kavishanGT/Electronic_Stethoscope/README.md

# Electronic_Stethoscope
E-Stethoscope is a real-time electronic stethoscope system designed to acquire, process, visualize, and record heart sounds (phonocardiogram – PCG) using an ESP32-based acquisition unit, MATLAB signal-processing
