kavishanGT/Electronic_Stethoscope/design files/New folder/Estetoscopio.SLDASM

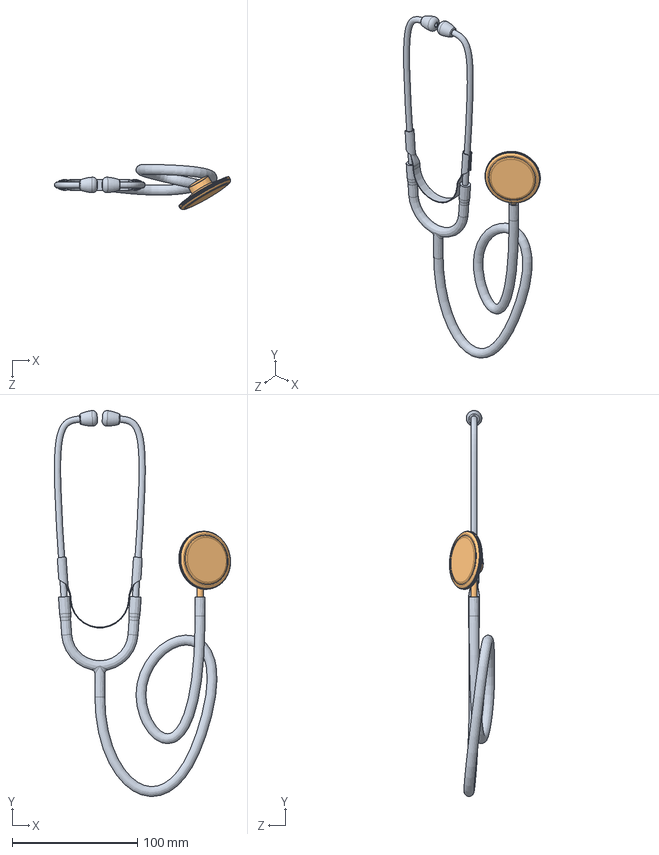
[picture p31: CAD file, 2025-12-25]
design files/New folder/Estetoscopio.SLDASM
140.6 x 307.9 x 36.1 mm
Olivas^_Estetoscopio
membrana^_Estetoscopio
