kavishanGT/Electronic_Stethoscope/design files/New folder/Assem1.SLDASM

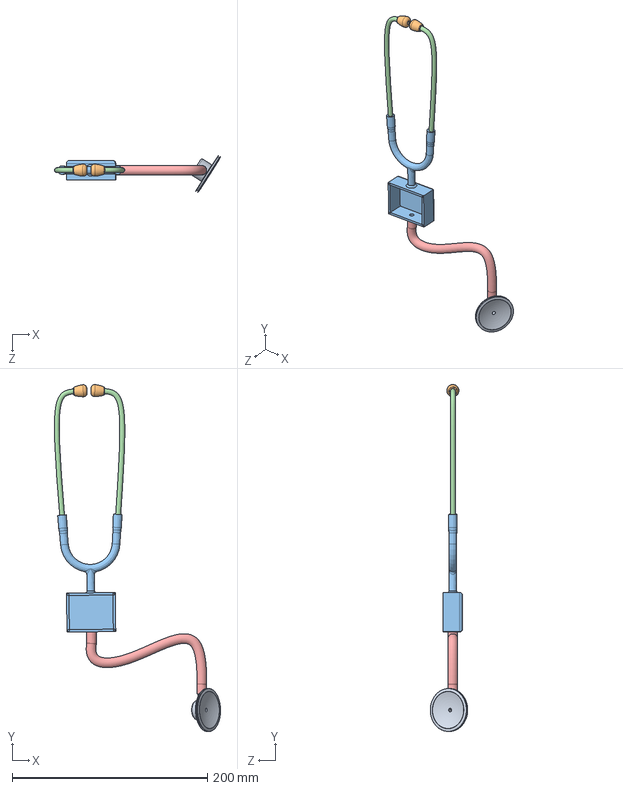
[picture p32: CAD file, 2025-12-25]
design files/New folder/Assem1.SLDASM
170.2 x 355.4 x 38.4 mm
chestPiece2-V2
earknobs-seth
yshape-steth-withBOX
2bars-steth
tube
