kavishanGT/Electronic_Stethoscope/design files/chestPiece2-V4.SLDPRT

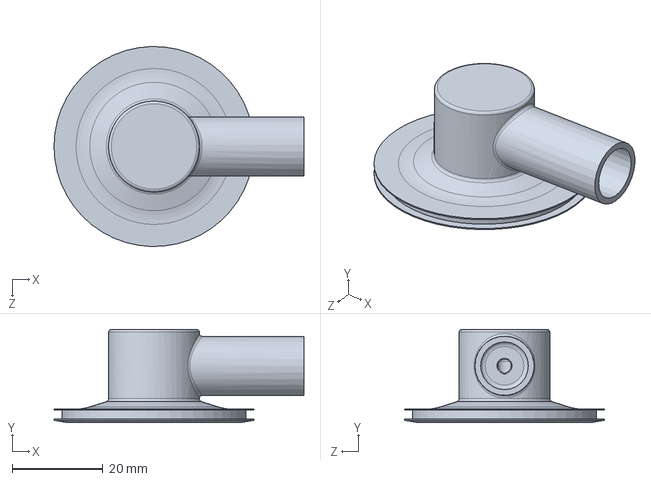
[picture p33: CAD file, 2025-12-25]
design files/chestPiece2-V4.SLDPRT
55.0 x 20.5 x 44.0 mm
