kavishanGT/Electronic_Stethoscope/design files/blabla.SLDPRT

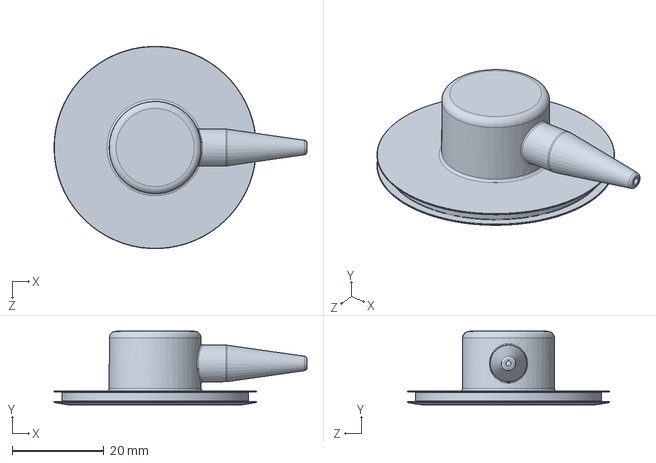
[picture p34: CAD file, 2025-12-25]
design files/blabla.SLDPRT
55.0 x 16.0 x 44.0 mm
