kavishanGT/Electronic_Stethoscope/design files/boxPartV3.SLDPRT

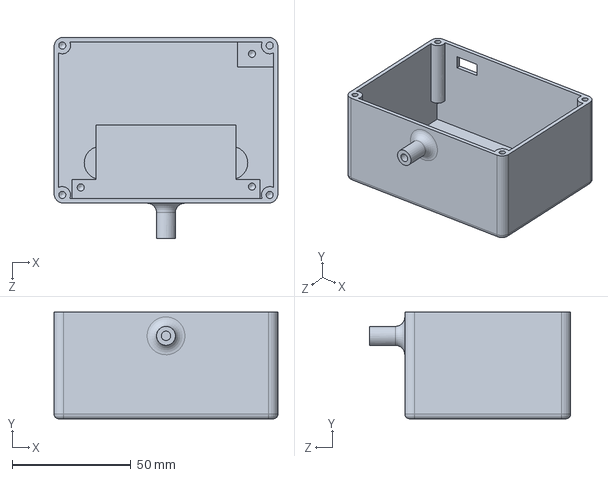
[picture p35: CAD file, 2025-12-25]
design files/boxPartV3.SLDPRT
94.5 x 45.0 x 85.0 mm
