kavishanGT/Electronic_Stethoscope/design files/New folder/steth - 2.SLDPRT

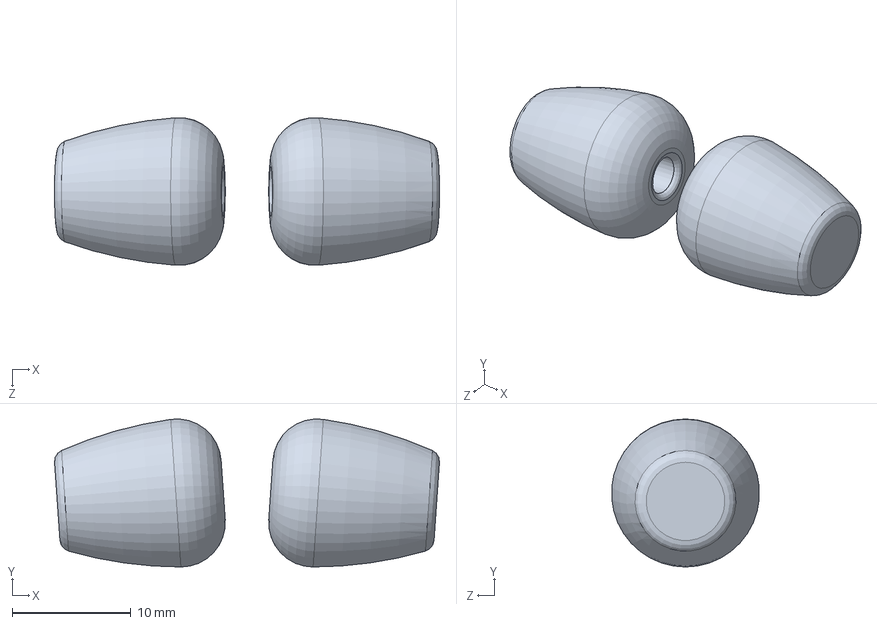
[picture p36: CAD file, 2025-12-25]
design files/New folder/steth - 2.SLDPRT
32.4 x 12.4 x 12.4 mm
