kavishanGT/Electronic_Stethoscope/design files/chestPiece2.SLDPRT

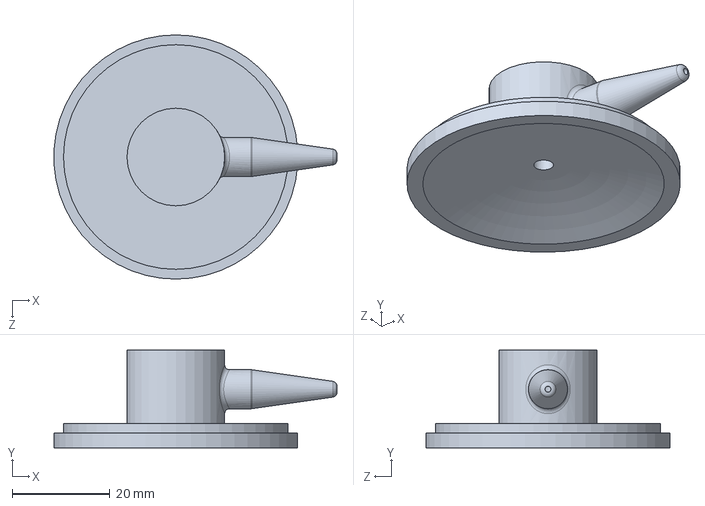
[picture p37: CAD file, 2025-12-25]
design files/chestPiece2.SLDPRT
58.0 x 20.0 x 50.0 mm
