kavishanGT/Electronic_Stethoscope/design files/New folder/yshape-steth.SLDPRT

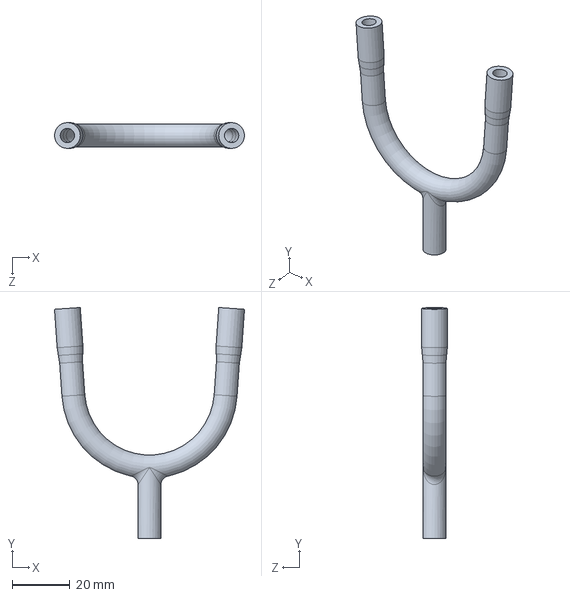
[picture p38: CAD file, 2025-12-25]
design files/New folder/yshape-steth.SLDPRT
66.1 x 80.3 x 9.00 mm
