kavishanGT/Electronic_Stethoscope/design files/New folder/yshape-steth-V2-withbox.SLDPRT

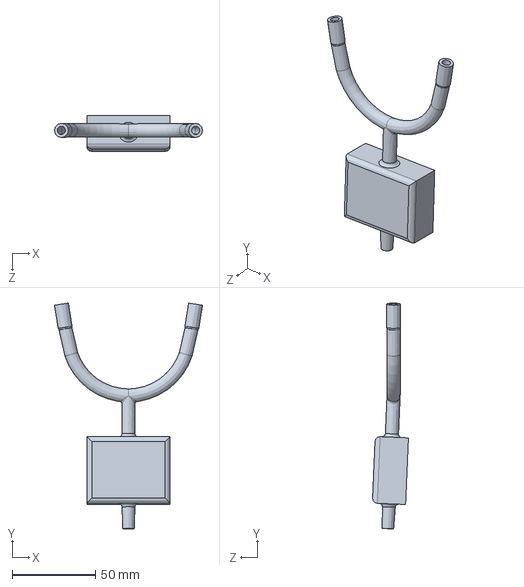
[picture p39: CAD file, 2025-12-25]
design files/New folder/yshape-steth-V2-withbox.SLDPRT
88.9 x 135.6 x 21.6 mm
