kavishanGT/Electronic_Stethoscope/design files/ring.SLDPRT

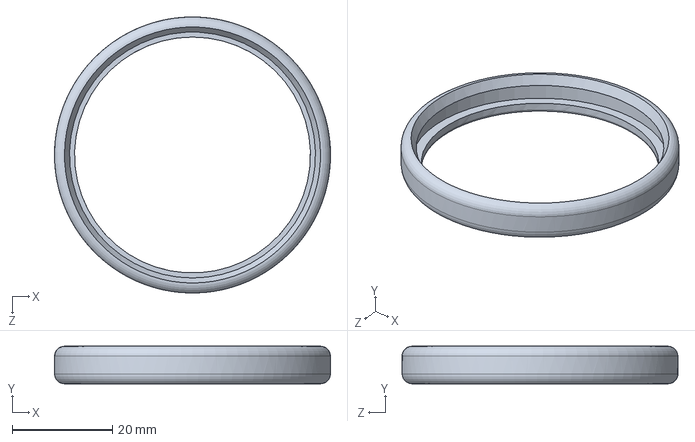
[picture p40: CAD file, 2025-12-25]
design files/ring.SLDPRT
55.0 x 7.50 x 55.0 mm
