kavishanGT/Electronic_Stethoscope/design files/boxLid.SLDPRT

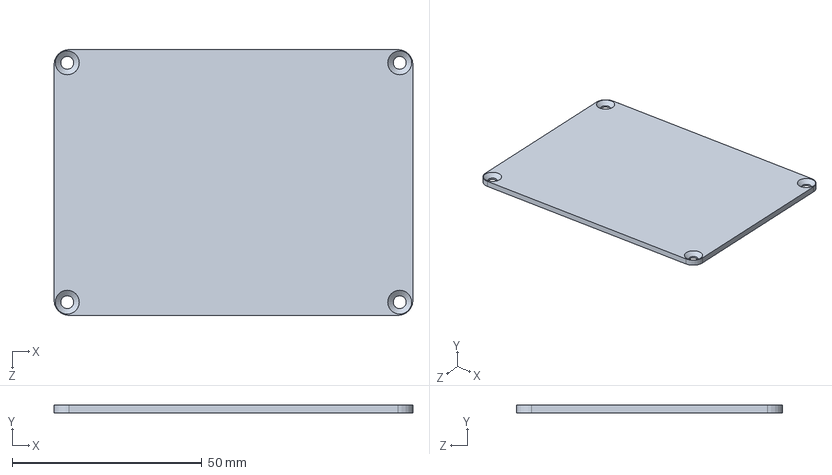
[picture p41: CAD file, 2025-12-25]
design files/boxLid.SLDPRT
94.5 x 2.00 x 70.0 mm
