kavishanGT/Electronic_Stethoscope/design files/New folder/2bars-steth.SLDPRT

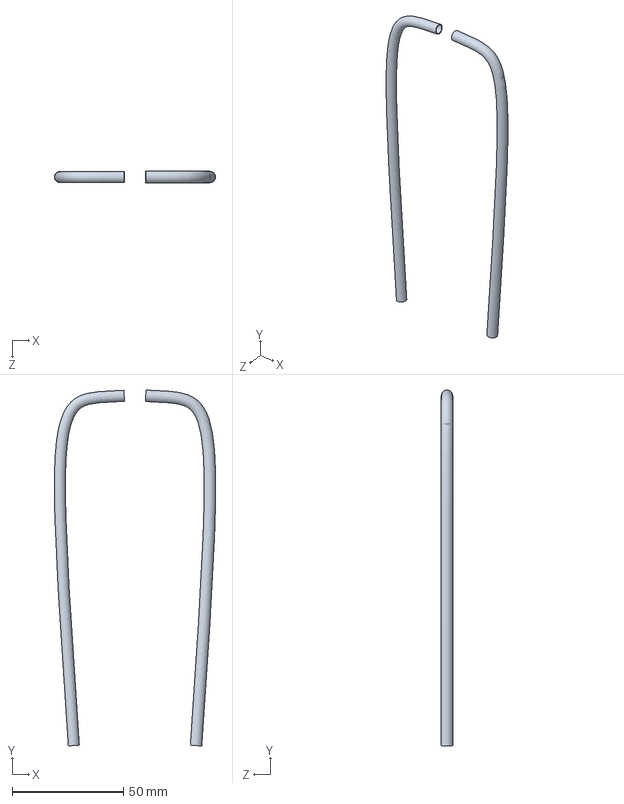
[picture p42: CAD file, 2025-12-25]
design files/New folder/2bars-steth.SLDPRT
72.6 x 160.2 x 5.20 mm
