kavishanGT/Electronic_Stethoscope/design files/chestPiece.SLDPRT

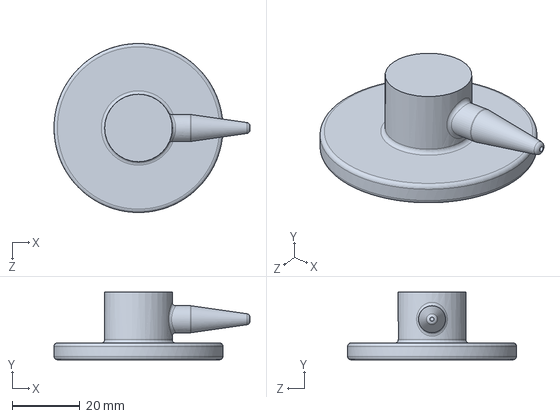
[picture p43: CAD file, 2025-12-25]
design files/chestPiece.SLDPRT
58.0 x 20.0 x 50.0 mm
