kavishanGT/Electronic_Stethoscope/design files/New folder/steth.SLDPRT

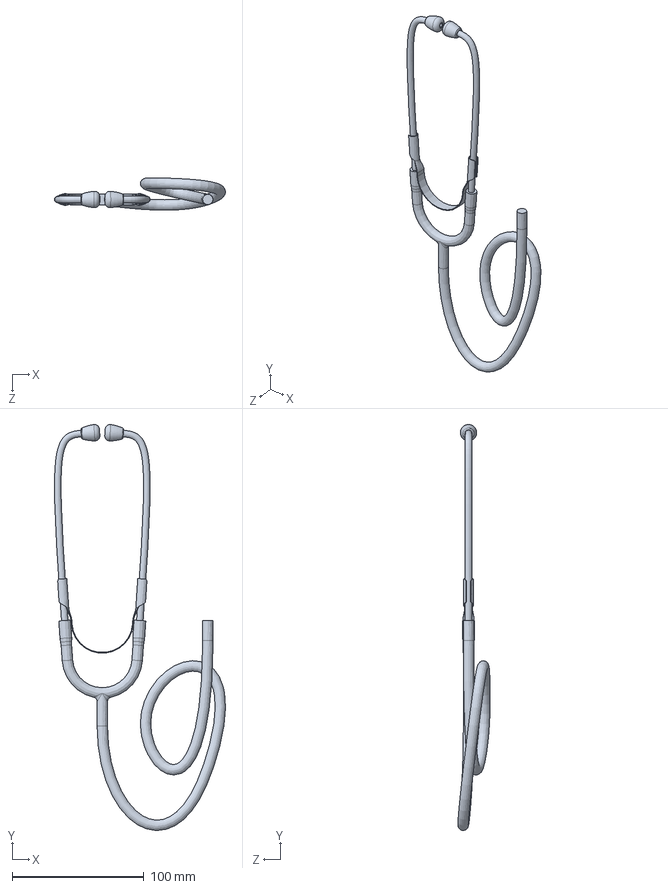
[picture p44: CAD file, 2025-12-25]
design files/New folder/steth.SLDPRT
129.7 x 307.9 x 24.5 mm
