kavishanGT/Electronic_Stethoscope/design files/boxPart.SLDPRT

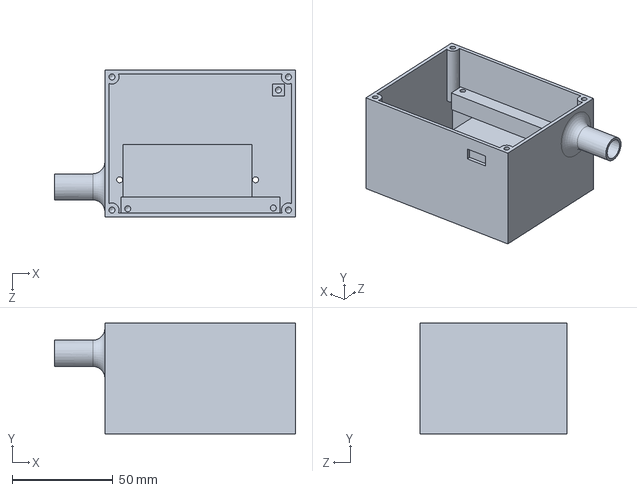
[picture p45: CAD file, 2025-12-25]
design files/boxPart.SLDPRT
119.5 x 55.0 x 73.0 mm
