kavishanGT/Electronic_Stethoscope/design files/New folder/2bars-steth-V2.SLDPRT

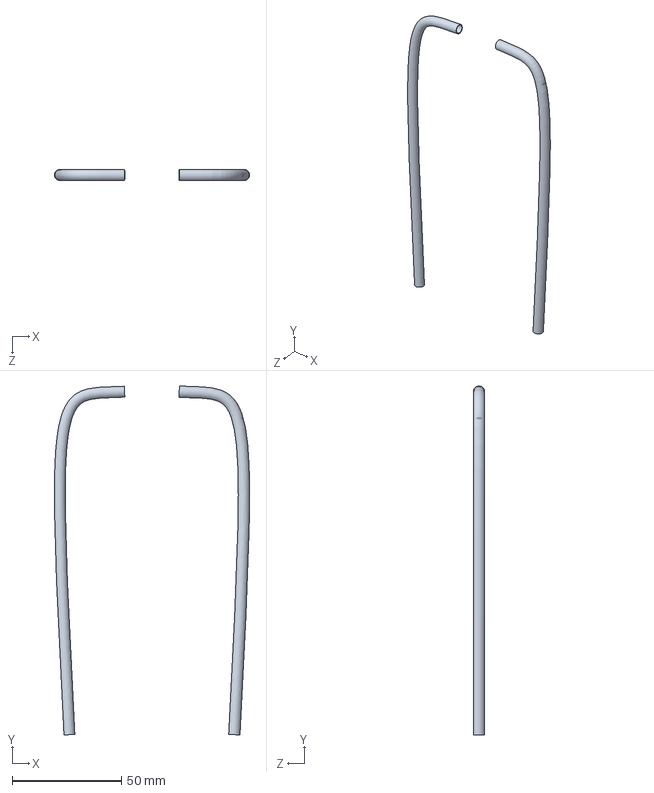
[picture p46: CAD file, 2025-12-25]
design files/New folder/2bars-steth-V2.SLDPRT
89.4 x 159.8 x 5.20 mm
