kavishanGT/Electronic_Stethoscope/design files/batteryTop.SLDPRT

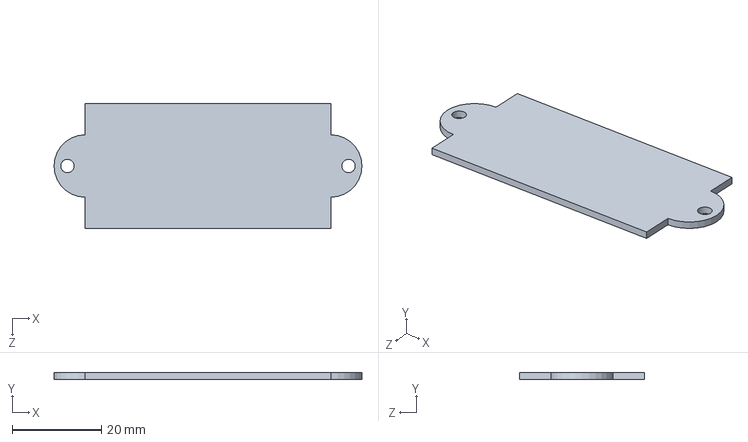
[picture p47: CAD file, 2025-12-25]
design files/batteryTop.SLDPRT
69.0 x 1.50 x 28.0 mm
