kavishanGT/Electronic_Stethoscope/design files/New folder/yshape-steth-V2.SLDPRT

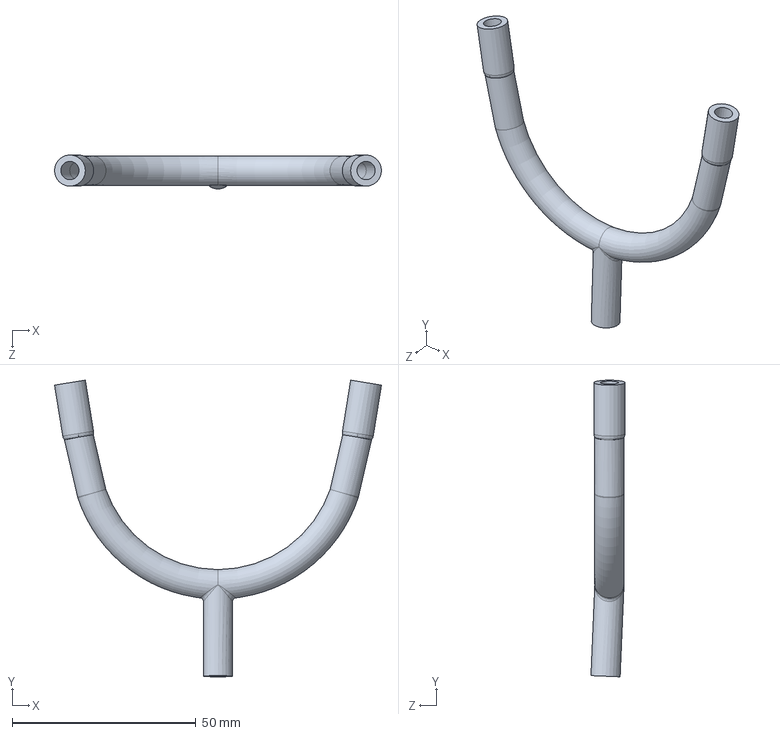
[picture p48: CAD file, 2025-12-25]
design files/New folder/yshape-steth-V2.SLDPRT
88.9 x 80.7 x 9.29 mm
