kavishanGT/Electronic_Stethoscope/design files/New folder/yshape-steth-withBOX.SLDPRT

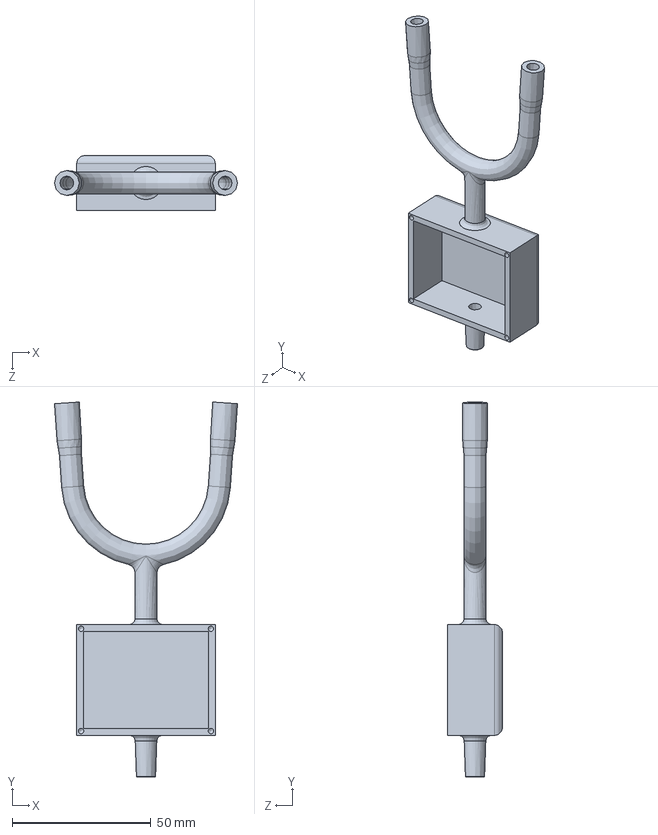
[picture p49: CAD file, 2025-12-25]
design files/New folder/yshape-steth-withBOX.SLDPRT
66.1 x 135.3 x 20.0 mm
