kavishanGT/Electronic_Stethoscope/design files/New folder/tube.SLDPRT

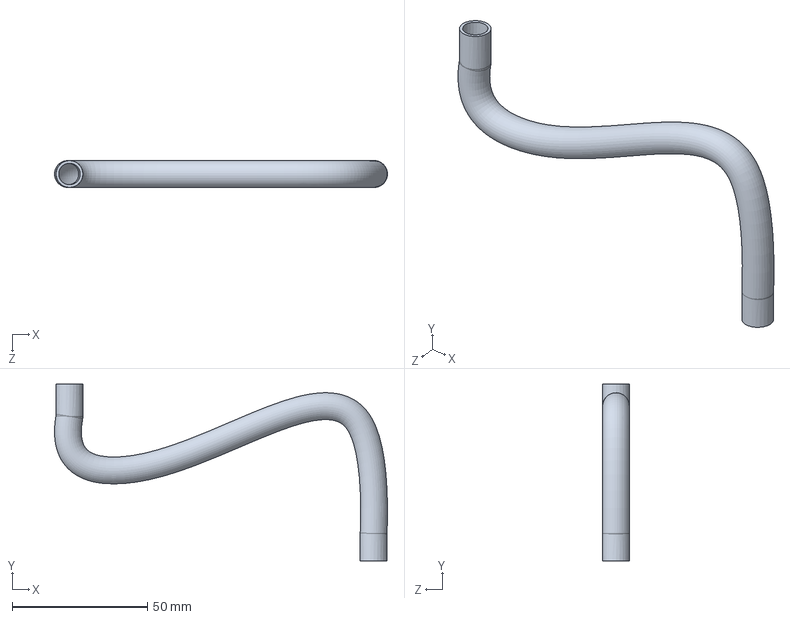
[picture p50: CAD file, 2025-12-25]
design files/New folder/tube.SLDPRT
122.9 x 65.3 x 9.95 mm
