kavishanGT/Electronic_Stethoscope/(list of files, cad)

Other CAD files:
design files/New folder/earknobs-seth.SLDPRT
design files/chestPiece2-V2.SLDPRT
design files/chestPiece2-V3.SLDPRT
